VAleSh-Soft/serial_alarm/docs/PCB/Schematic_serial_alarm_1.5x.png

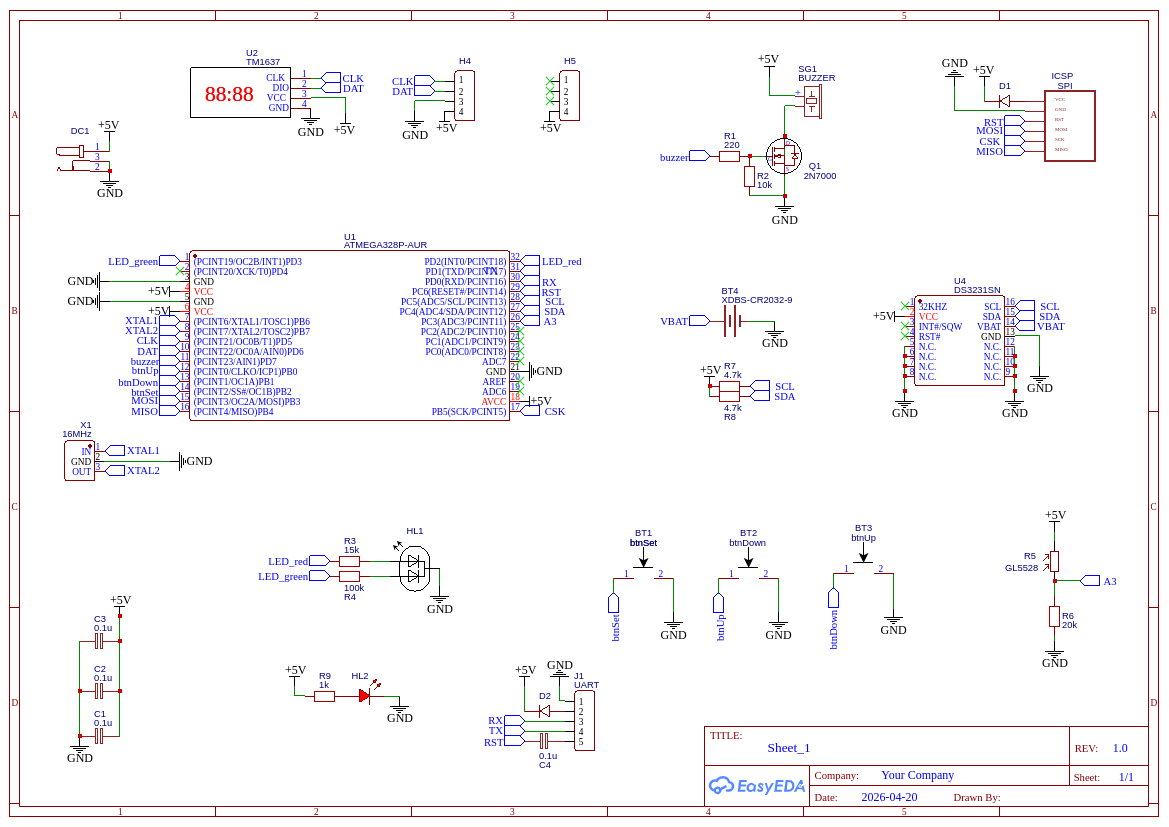
docs/PCB/Schematic_serial_alarm_1.5x.png
