VAleSh-Soft/serial_alarm/docs/manual.pdf

https://github.com/VAleSh-Soft/serial_alarm

## Последовательный звуковой сигнализатор

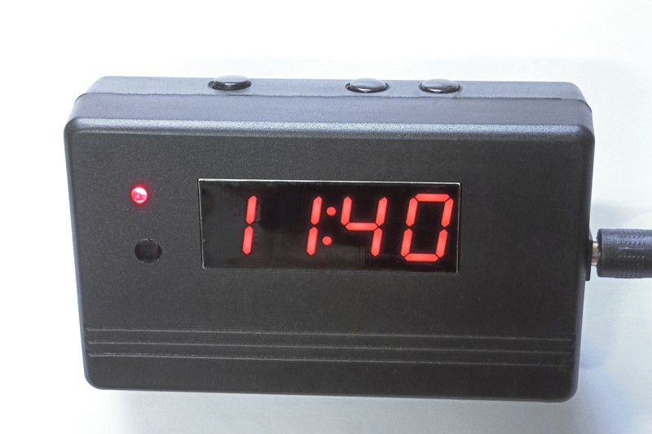
[picture p12: figure]

### Инструкция по эксплуатации

2022 - 2026

### Содержание

### Описание

Прибор представляет собой часы с возможностью выдачи звукового сигнала через равные интервалы времени в промежутке между заданным временем начала и конца сигнализации.
Например, если задан промежуток с 21:00 до 05:00 с интервалом в два часа, сигнал сигнализатора будет срабатывать в 21:00, 23:00, 01:00 и 03:00. Время 05:00 является временем завершения работы и перехода сигнализатора в неактивный режим до 21:00. Если нужно, чтобы сигнал сработал и в 05:00, время окончания нужно задать хотя бы на минуту позже — 05:01.

### Управление

Прибор управляются тремя кнопками (слева направо):
- «Установки» — вход в режимы настроек времени и сигнализатора, выбор настраиваемого параметра и сохранение изменений;
- «-» — уменьшение текущих значений;
- «+» — увеличение текущих значений.
Вход в режимы настроек выполняется из режима отображения текущего времени (режим по умолчанию).
Изменяемый параметр обозначается миганием символов.
При отсутствии активности пользователя в течение шести секунд прибор возвращается в режим отображения текущего времени. Все внесенные изменения при этом будут сохранены.

Настройка текущего времени
Вход в настройки текущего времени выполняется удержанием нажатой в течение одной секунды кнопки «Установки».
Последовательно устанавливаются часы и минуты, переход к настройке минут выполняется коротким кликом кнопки «Установки». Текущие секунды в часах при сохранении времени автоматически обнуляются.

### Звуковой сигнализатор

Состояние сигнализатора показывает двухцветный светодиод рядом с основным экраном — если сигнализатор включен, светодиод светится, при этом, если текущее время входит в рабочий промежуток (сигнализатор в активном режиме), светодиод светится зеленым цветом, иначе (сигнализатор в неактивном режиме) — красным; если сигнализатор сработал, светодиод мигает зеленым.
Сигнал сработавшего сигнализатора отключается нажатием на любую кнопку.

Настройка сигнализатора
В режим настройки сигнализатора можно перейти по двойному клику кнопкой «Установки». Включение/выключение сигнализатора выполняется кнопками «+» или «-». После включения сигнализатора следующее нажатие кнопки «Установки» переводит в режим настройки времени и интервала срабатывания.
Каждый раздел настроек сигнализатора обозначается соответствующими символами:
- «AL:» — включение/отключение сигнализатора;
- «Р1:» — время начала (переход сигнализатора в активное состояние и первое срабатывание);
- «Р2:» — время окончания (переход сигнализатора в неактивное состояние);
- «It:» — интервал срабатывания (настраивается в диапазоне 10-180 минут с шагом в 10 минут);

Для однократного (один раз в сутки) срабатывания сигнализатора достаточно задать одинаковое время начала и конца, величина интервала при этом настраиваться не будет.

### Дополнительные возможности

Автоматическое управление яркостью экрана
При пониженном освещении яркость экрана автоматически снижается для уменьшения нагрузки на глаза. Датчик освещенности расположен под индикаторным светодиодом сигнализатора.

Регулировка минимального и максимального уровней яркости экрана
В режим регулировки яркости экрана можно перейти, удерживая одновременно нажатыми в течение одной секунды кнопки «+» и «-». Раздельно можно настраивать минимальный («b1:»), максимальный («b2:») уровни, а так же порог переключения («th:»).
Кнопка «Установки» в этом режиме сохраняет введенные данные и переключает режимы, кнопками «+» и «-» настраивается желаемый уровень. Яркость может иметь значение в интервале 1 .. 7, порог переключения — 1 .. 9.

Вывод на экран текущей температуры
Прибор имеет возможность отображать текущую температуру воздуха в помещении. Для вывода на экран температуры кликнуть кнопкой «+» в режиме отображения текущего времени.
Кроме того, есть возможность автоматического регулярного вывода температуры на экран. Для включения или отключения этой опции нужно удерживать нажатой в течение одной секунды кнопку «-». Отобразится экран, обозначенный символом «Au:», кнопками «+» и «-» можно выбрать желаемый интервал вывода данных. Доступные значения — 0, 1, 5, 10, 15, 20, 30, 60 минут, при выборе значения 0 автовывод отключается.

Вывод на экран текущих настроек сигнализатора
В режиме отображения текущего времени клик кнопкой «Установки» выводит на экран данные по текущим настройкам сигнализатора — время перехода сигнализатора в активное состояние («P1:»), время перехода сигнализатора в неактивное состояние («P2:»), интервал срабатывания сигнализатора («It:») и время следующего срабатывания («Pn:»). Данные выводятся только в случае, если сигнализатор включен. Если задано одинаковое время «P1» и «P2» (однократное срабатывание будильника), то будет показано только время «P1».

Вывод на экран списка точек срабатывания сигнализатора
В режиме отображения текущего времени удержание нажатой в течение одной секунды кнопки «+» последовательно выводит на экран все точки времени, когда согласно текущих настроек будет срабатывать сигнализатор. Данные так же выводятся только в случае, если сигнализатор включен.
