VAleSh-Soft/serial_alarm/alarm.h

/**
 * @file alarm.h
 * @author Vladimir Shatalov (valesh-soft@yandex.ru)
 *
 * @brief Будильник с возможностью выдачи сигнала через равные интервалы
 *        времени в заданном промежутке времени начала и окончания
 *        сигнализации;
 *
 *        несмотря на использование библиотеки shSimpleClock, использовать
 *        встроенный в нее будильник не получится, т.к. он рассчитан на одно
 *        время срабатывания, а нам нужно настраивать время начала и окончания
 *        сигнализации и интервал срабатывания;
 *
 * @version 1.0
 * @date 2026-06-09
 *
 * @copyright Copyright (c) 2026
 *
 */
#pragma once
#include <Arduino.h>
#include <EEPROM.h>

#define MAX_DATA 1439        // максимальное количество минут для установки будильника (23 ч, 59 мин)
#define MAX_INTERVAL 180     // максимальный интервал, минут
#define MIN_INTERVAL 10      // минимальный интервал, минут
#define INTERVAL_INC_STEP 10 // шаг изменения интервала, минут
#define ALARM_DURATION 60    // продолжительность сигнала будильника, секунд

enum IndexOffset : uint8_t // смещение от стартового индекса в EEPROM для хранения настроек
/* общий размер настроек - 7 байт */
{
  ALARM_STATE = 0,   // состояние будильника, включен/нет, uint8_t
  ALARM_POINT_1 = 1, // начало отсчета времени сигнализации в минутах от полуночи, uint16_t
  ALARM_POINT_2 = 3, // конец отсчета времени сигнализации в минутах от полуночи, uint16_t
  ALARM_INTERVAL = 5 // интервал срабатывания будильника в минутах, uint16_t
};

enum AlarmState : uint8_t // состояние будильника
{
  ALARM_OFF, // будильник выключен
  ALARM_ON,  // будильник включен
  ALARM_YES  // будильник сработал
};

class SerialAlarm
{
private:
  uint8_t red_pin;
  uint8_t green_pin;
  uint16_t eeprom_index;
  AlarmState state;
  uint16_t next_point;

  uint8_t read_eeprom_8(IndexOffset _index);

  uint16_t read_eeprom_16(IndexOffset _index);

  void write_eeprom_8(IndexOffset _index, uint8_t _data);

  void write_eeprom_16(IndexOffset _index, uint16_t _data);

  void setNextPoint(uint16_t _time);

  void setLed(uint16_t _time);

public:
  SerialAlarm(uint8_t _red_pin, uint8_t _green_pin, uint16_t _eeprom_index);

  /**
   * @brief первоначальное определение точки следующего срабатывания будильника при включении или при изменении настроек будильника
   *
   * @param _time текущее время
   */
  void init(clkDateTime _time);

  /**
   * @brief получение текущего состояния будильника
   *
   * @return AlarmState
   */
  AlarmState getAlarmState();

  /**
   * @brief установка текущего состояния будильника
   *
   * @param _state новое значение состояния будильника
   */
  void setAlarmState(AlarmState _state);

  /**
   * @brief проверка времени на вхождение в интервал
   *
   * @param _time количество минут с начала суток
   * @return true
   * @return false
   */
  bool checkForInterval(uint16_t &_time);

  /**
   * @brief получение информации о состоянии будильника - включен/выключен
   *
   * @return true
   * @return false
   */
  bool getOnOffAlarm();

  /**
   * @brief включение/выключение будильника
   *
   * @param _state флаг для установки состояния будильника
   */
  void setOnOffAlarm(bool _state);

  /**
   * @brief получение времени следующего срабатывания будильника
   *
   * @return uint16_t время следующего срабатывания в минутах от начала суток
   */
  uint16_t getNextPoint();

  /**
   * @brief получение времени перехода будильника в активный режим
   *
   * @return uint16_t время в минутах от начала суток
   */
  uint16_t getAlarmPoint1();

  /**
   * @brief установка времени перехода будильника в активный режим
   *
   * @param _time время в минутах от начала суток
   */
  void setAlarmPoint1(uint16_t _time);

  /**
   * @brief получение времени перехода будильника в неактивный режим
   *
   * @return uint16_t время в минутах от начала суток
   */
  uint16_t getAlarmPoint2();

  /**
   * @brief установка времени перехода будильника в неактивный режим
   *
   * @param _time время в минутах от начала суток
   */
  void setAlarmPoint2(uint16_t _time);

  /**
   * @brief получение действующего интервала срабатывания будильника (минут)
   *
   * @return uint16_t
   */
  uint16_t getAlarmInterval();

  /**
   * @brief установка интервала срабатывания будильника
   *
   * @param _time устанавливаемый интервал в минутах
   */
  void setAlarmInterval(uint16_t _time);

  /**
   * @brief проверка текущего состояния будильника
   *
   * @param _time текущее время
   */
  void tick(clkDateTime _time);
};

// ---- private ---------------------------------

uint8_t SerialAlarm::read_eeprom_8(IndexOffset _index)
{
  return (EEPROM.read(eeprom_index + _index));
}

uint16_t SerialAlarm::read_eeprom_16(IndexOffset _index)
{
  uint16_t _data;
  EEPROM.get(eeprom_index + _index, _data);
  return (_data);
}

void SerialAlarm::write_eeprom_8(IndexOffset _index, uint8_t _data)
{
  EEPROM.update(eeprom_index + _index, _data);
}

void SerialAlarm::write_eeprom_16(IndexOffset _index, uint16_t _data)
{
  EEPROM.put(eeprom_index + _index, _data);
}

void SerialAlarm::setNextPoint(uint16_t _time)
{
  next_point = (_time < MAX_DATA + 1) ? _time : _time - (MAX_DATA + 1);
}

bool SerialAlarm::checkForInterval(uint16_t &_time)
{
  uint16_t p1 = getAlarmPoint1();
  uint16_t p2 = getAlarmPoint2();

  if (_time >= MAX_DATA + 1)
  {
    _time -= MAX_DATA + 1;
  }

  if (p1 == p2)
  {
    return (false);
  }

  if (p2 > p1)
  {
    return ((_time >= p1) && (_time < p2));
  }
  else
  {
    return ((_time >= p1) || (_time < p2));
  }
}

void SerialAlarm::setLed(uint16_t _time)
{
  static uint8_t n = 0;
  uint8_t red_state = LOW;
  uint8_t green_state = LOW;
  if (state == ALARM_YES)
  { // при сработавшем будильнике светодиод мигает зеленым с периодом 0.2 секунды
    green_state = n;
    if (++n > 1)
    {
      n = 0;
    }
  }
  else if (state)
  {
    (checkForInterval(_time)) ? green_state = HIGH : red_state = HIGH;
  }
  digitalWrite(red_pin, red_state);
  digitalWrite(green_pin, green_state);
}

// ---- public ----------------------------------

SerialAlarm::SerialAlarm(uint8_t _red_pin, uint8_t _green_pin, uint16_t _eeprom_index)
{
  red_pin = _red_pin;
  pinMode(red_pin, OUTPUT);
  green_pin = _green_pin;
  pinMode(green_pin, OUTPUT);
  eeprom_index = _eeprom_index;
  if (read_eeprom_8(ALARM_STATE) > 1)
  {
    write_eeprom_8(ALARM_STATE, 0);
  }
  if (read_eeprom_16(ALARM_POINT_1) > MAX_DATA)
  {
    write_eeprom_16(ALARM_POINT_1, (uint16_t)8 * 60);
  }
  if (read_eeprom_16(ALARM_POINT_2) > MAX_DATA)
  {
    write_eeprom_16(ALARM_POINT_2, 17 * 60 + 1);
  }
  if ((read_eeprom_16(ALARM_INTERVAL) > MAX_INTERVAL) ||
      (read_eeprom_16(ALARM_INTERVAL) < MIN_INTERVAL))
  {
    write_eeprom_16(ALARM_INTERVAL, 60);
  }
  state = (AlarmState)read_eeprom_8(ALARM_STATE);
}

void SerialAlarm::init(clkDateTime _time)
{
  uint16_t p1 = getAlarmPoint1();
  uint16_t p2 = getAlarmPoint2();

  uint32_t tm = _time.hour() * 3600ul + _time.minute() * 60ul + _time.second();
  if (p2 < p1)
  {
    tm += (MAX_DATA + 1) * 60ul;
  }

  uint16_t x = p1;
  uint16_t it = getAlarmInterval();

  while (x * 60ul < tm)
  {
    x += it;
  }
  if (!checkForInterval(x))
  {
    x = p1;
  }

  setNextPoint(x);
}

AlarmState SerialAlarm::getAlarmState() { return (state); }

void SerialAlarm::setAlarmState(AlarmState _state) { state = _state; }

bool SerialAlarm::getOnOffAlarm() { return (bool)read_eeprom_8(ALARM_STATE); }

void SerialAlarm::setOnOffAlarm(bool _state)
{
  write_eeprom_8(ALARM_STATE, (uint8_t)_state);
  state = (AlarmState)_state;
}

uint16_t SerialAlarm::getNextPoint() { return next_point; }

uint16_t SerialAlarm::getAlarmPoint1() { return (read_eeprom_16(ALARM_POINT_1)); }

void SerialAlarm::setAlarmPoint1(uint16_t _time) { write_eeprom_16(ALARM_POINT_1, _time); }

uint16_t SerialAlarm::getAlarmPoint2() { return (read_eeprom_16(ALARM_POINT_2)); }

void SerialAlarm::setAlarmPoint2(uint16_t _time) { write_eeprom_16(ALARM_POINT_2, _time); }

uint16_t SerialAlarm::getAlarmInterval() { return (read_eeprom_16(ALARM_INTERVAL)); }

void SerialAlarm::setAlarmInterval(uint16_t _time)
{
  if (_time > MAX_INTERVAL)
  {
    _time = MAX_INTERVAL;
  }
  write_eeprom_16(ALARM_INTERVAL, _time);
}

void SerialAlarm::tick(clkDateTime _time)
{
  uint16_t tm = _time.hour() * 60 + _time.minute();
  setLed(tm);

  if (state == ALARM_ON)
  {
    if (tm * 60ul + _time.second() == next_point * 60ul)
    {
      state = ALARM_YES;
      setNextPoint(next_point + read_eeprom_16(ALARM_INTERVAL));
      if (!checkForInterval(next_point))
      {
        next_point = getAlarmPoint1();
      }
    }
  }
}

// ===================================================

SerialAlarm saAlarm(ALARM_RED_PIN, ALARM_GREEN_PIN, ALARM_EEPROM_INDEX);
