VAleSh-Soft/serial_alarm/(commit log)

2026-07-25 add pcb folder
2026-07-25 add schematic for pcb
2026-07-25 update pcb
2026-07-25 update schematic
2026-08-01 add pcb for LT
